henrynester/spinor-r2/hw/r2.1/hn_lib/3dmodels/hn_LED.step

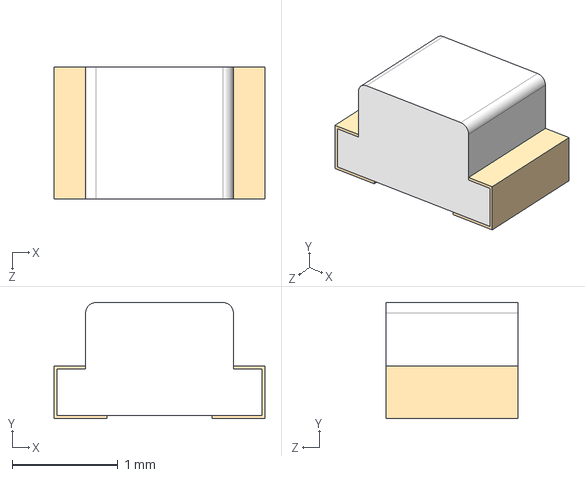
[picture p1: CAD file, 2026-01-27]
hw/r2.1/hn_lib/3dmodels/hn_LED.step
2.00 x 1.10 x 1.25 mm
