henrynester/spinor-r2/hw/r2.1/hn_lib/3dmodels/hn_R_0805.step

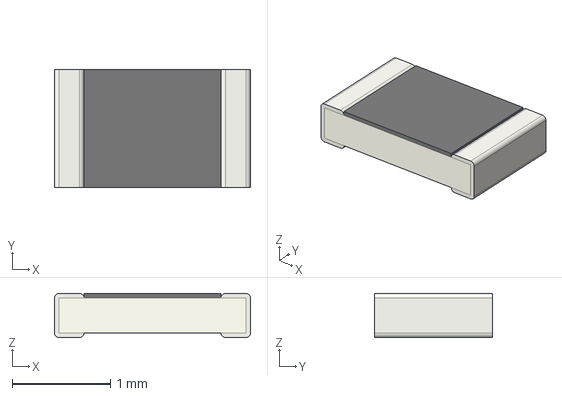
[picture p2: CAD file, 2026-01-27]
hw/r2.1/hn_lib/3dmodels/hn_R_0805.step
2.00 x 1.20 x 0.45 mm
