henrynester/spinor-r2/hw/r2.1/hn_lib/3dmodels/hn_C_0402.step

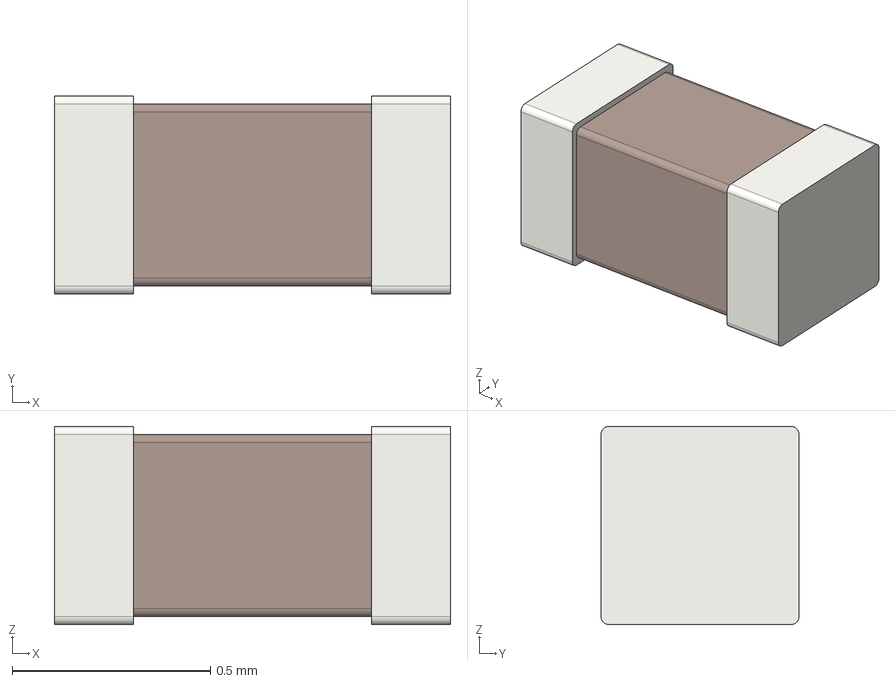
[picture p3: CAD file, 2026-01-27]
hw/r2.1/hn_lib/3dmodels/hn_C_0402.step
1.00 x 0.5 x 0.5 mm
