henrynester/spinor-r2/hw/r2.1/hn_lib/3dmodels/hn_D_SOD-523.step

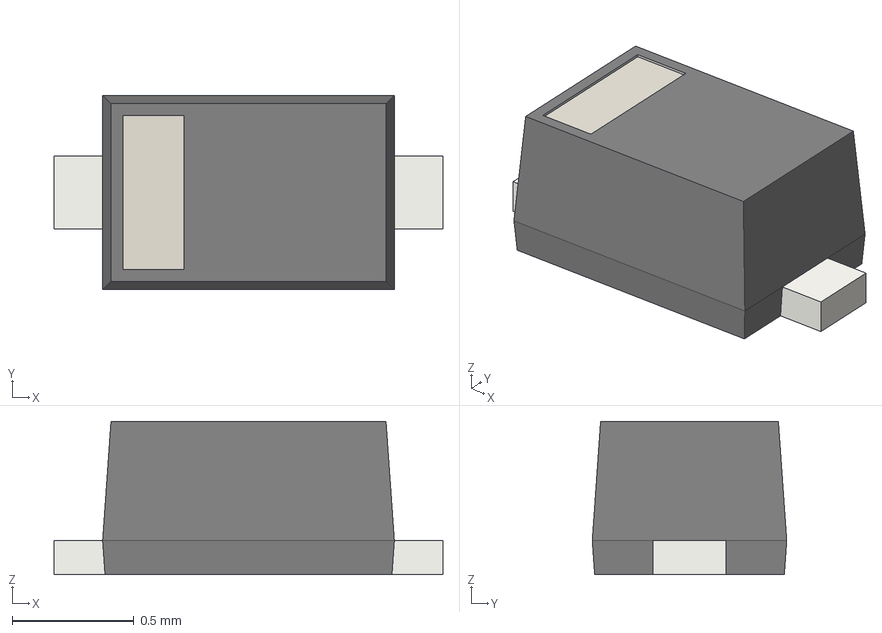
[picture p4: CAD file, 2026-01-27]
hw/r2.1/hn_lib/3dmodels/hn_D_SOD-523.step
1.60 x 0.8 x 0.63 mm
