henrynester/spinor-r2/hw/r2.1/hn_lib/3dmodels/hn_L_Bourns_SRN4026.step

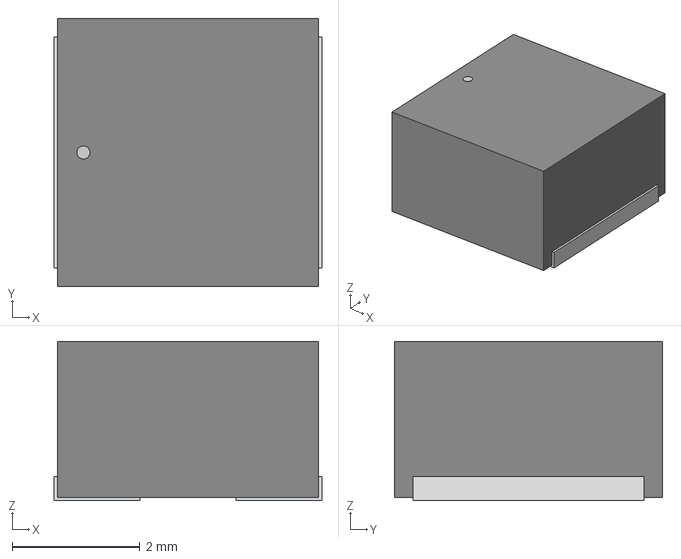
[picture p5: CAD file, 2026-01-27]
hw/r2.1/hn_lib/3dmodels/hn_L_Bourns_SRN4026.step
4.19 x 4.19 x 2.49 mm
