henrynester/spinor-r2/hw/r2.1/hn_lib/3dmodels/hn_QFN40_6x6mm.step

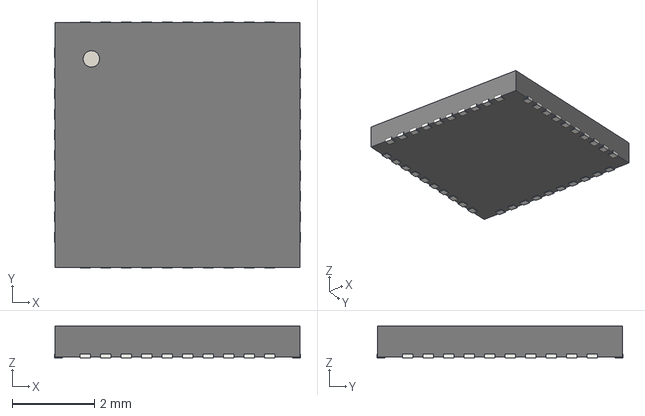
[picture p6: CAD file, 2026-01-27]
hw/r2.1/hn_lib/3dmodels/hn_QFN40_6x6mm.step
6.00 x 6.00 x 0.78 mm
