henrynester/spinor-r2/hw/r2.1/hn_lib/3dmodels/hn_TPS560430X3F.step

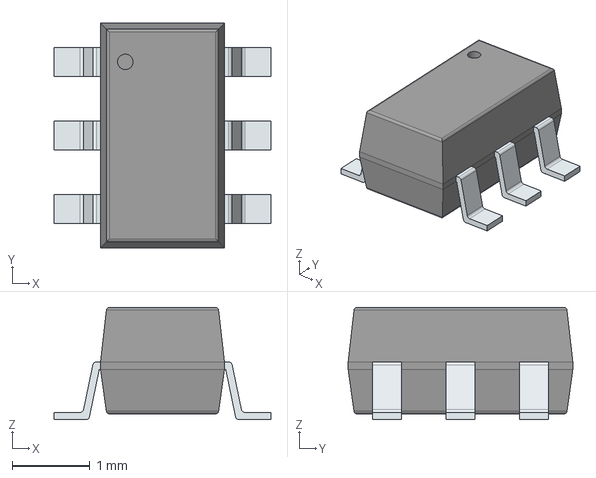
[picture p7: CAD file, 2026-01-27]
hw/r2.1/hn_lib/3dmodels/hn_TPS560430X3F.step
2.80 x 2.90 x 1.45 mm
PinsArrayLR
