henrynester/spinor-r2/hw/r2.1/hn_lib/3dmodels/hn_xtal.step

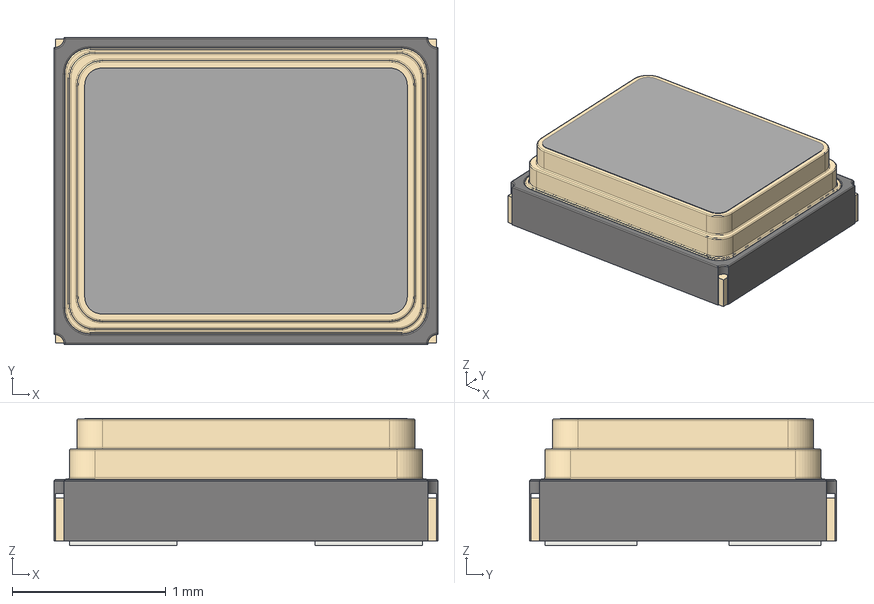
[picture p8: CAD file, 2026-01-27]
hw/r2.1/hn_lib/3dmodels/hn_xtal.step
2.50 x 2.00 x 0.83 mm
