henrynester/spinor-r2/hw/r2.1/hn_lib/3dmodels/hn_SOPAdvance8.step

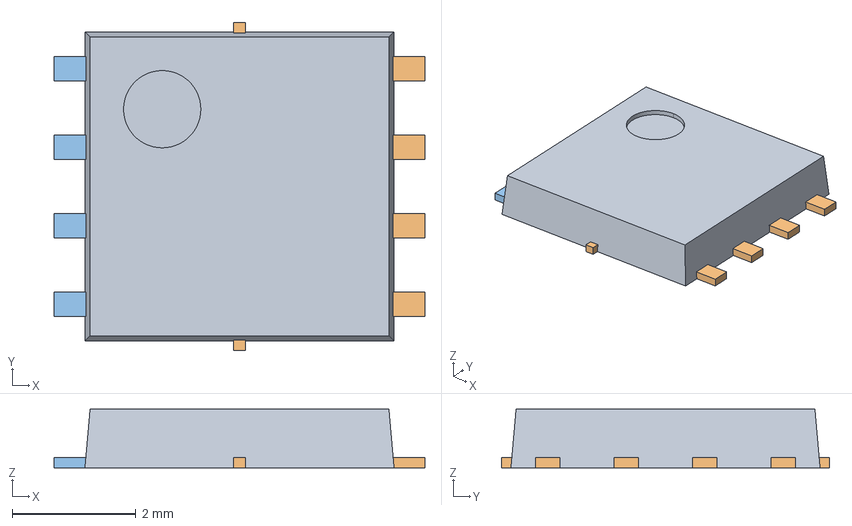
[picture p9: CAD file, 2026-01-27]
hw/r2.1/hn_lib/3dmodels/hn_SOPAdvance8.step
6.00 x 5.30 x 0.95 mm
