henrynester/spinor-r2/hw/r2.1/hn_lib/3dmodels/hn_TSSOP14.step

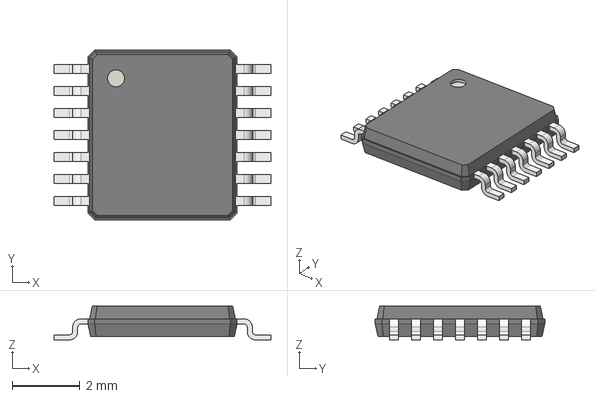
[picture p11: CAD file, 2026-01-27]
hw/r2.1/hn_lib/3dmodels/hn_TSSOP14.step
6.40 x 5.00 x 1 mm
