henrynester/spinor-r2/hw/r2.1/hn_lib/3dmodels/hn_C_Kemet_A768MS.step

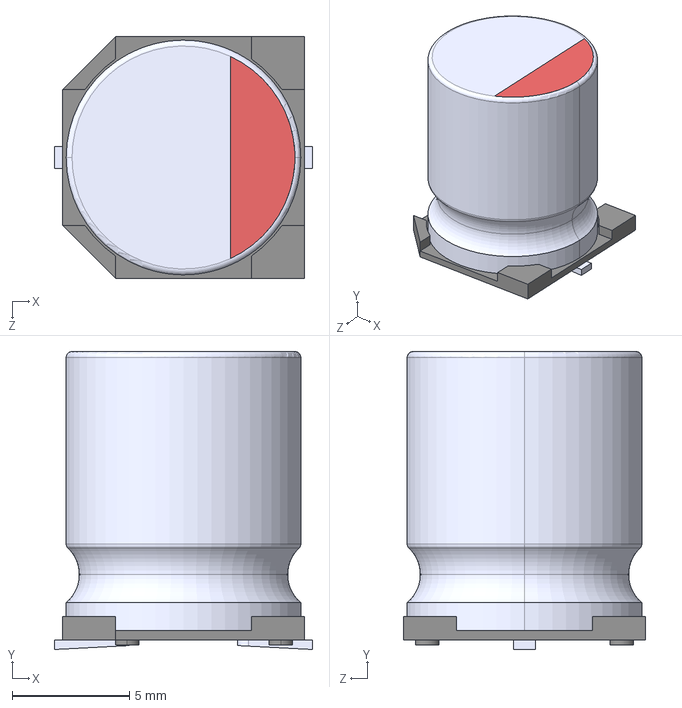
[picture p12: CAD file, 2026-01-27]
hw/r2.1/hn_lib/3dmodels/hn_C_Kemet_A768MS.step
11.0 x 12.7 x 10.3 mm
