henrynester/spinor-r2/hw/r2.1/hn_lib/3dmodels/hn_S3B-XH-SM4-TB.step

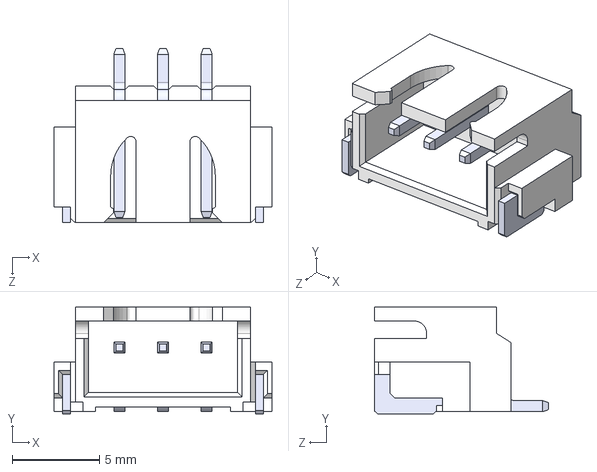
[picture p13: CAD file, 2026-01-27]
hw/r2.1/hn_lib/3dmodels/hn_S3B-XH-SM4-TB.step
12.5 x 6.12 x 10.0 mm
SxB-XH-SM4-TB_3
pin^SxB-XH-SM4-TB Ass x 3
