henrynester/spinor-r2/hw/r2.1/hn_lib/3dmodels/hn_SOT-23-3.step

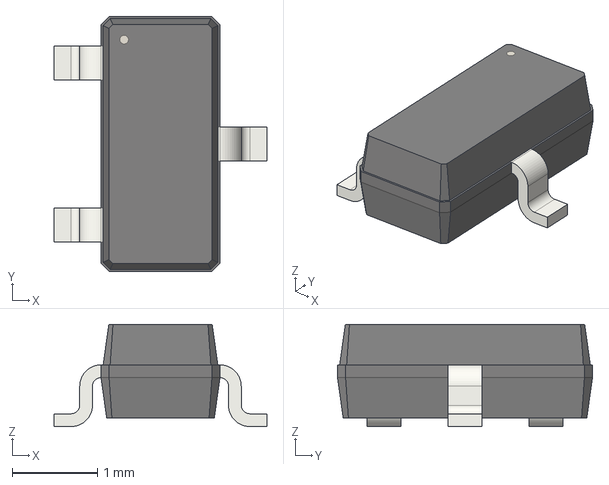
[picture p14: CAD file, 2026-01-27]
hw/r2.1/hn_lib/3dmodels/hn_SOT-23-3.step
2.50 x 3.00 x 1.20 mm
