henrynester/spinor-r2/hw/r2.1/hn_lib/3dmodels/hn_SOIC8.step

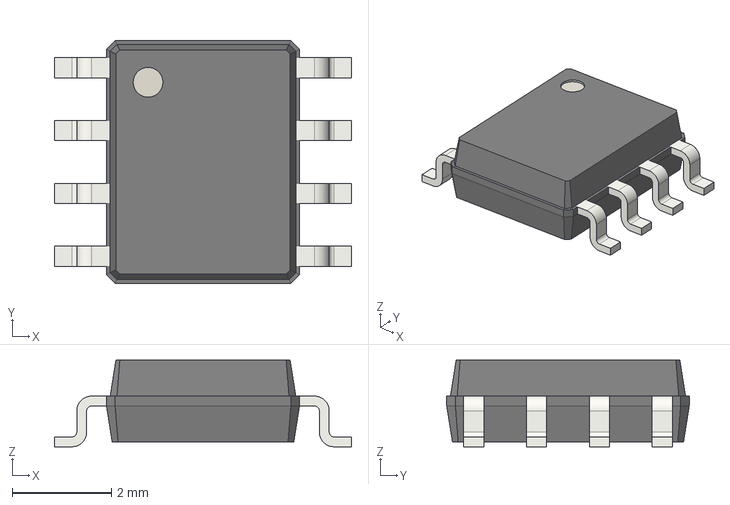
[picture p15: CAD file, 2026-01-27]
hw/r2.1/hn_lib/3dmodels/hn_SOIC8.step
6.00 x 4.90 x 1.75 mm
