henrynester/spinor-r2/hw/r2.1/hn_lib/3dmodels/hn_C_1206.step

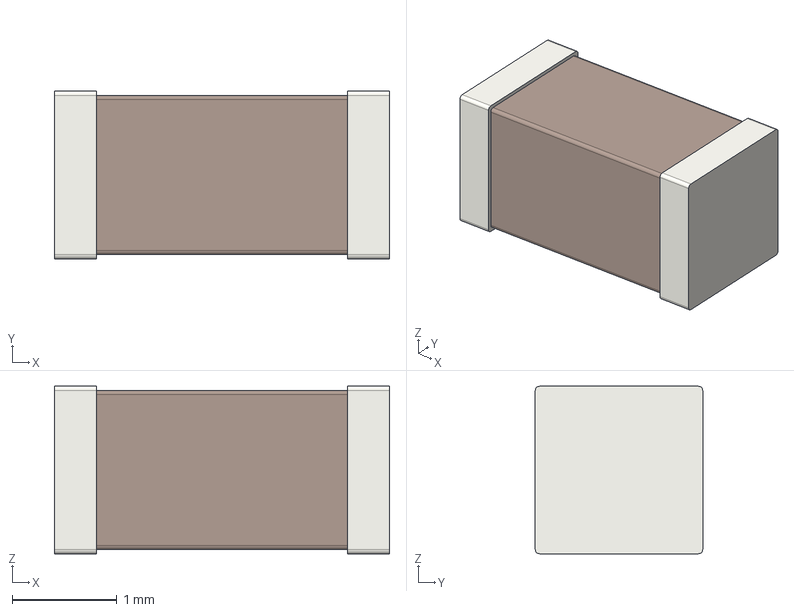
[picture p16: CAD file, 2026-01-27]
hw/r2.1/hn_lib/3dmodels/hn_C_1206.step
3.20 x 1.60 x 1.60 mm
