henrynester/spinor-r2/hw/r2.1/hn_lib/3dmodels/hn_C_0603.step

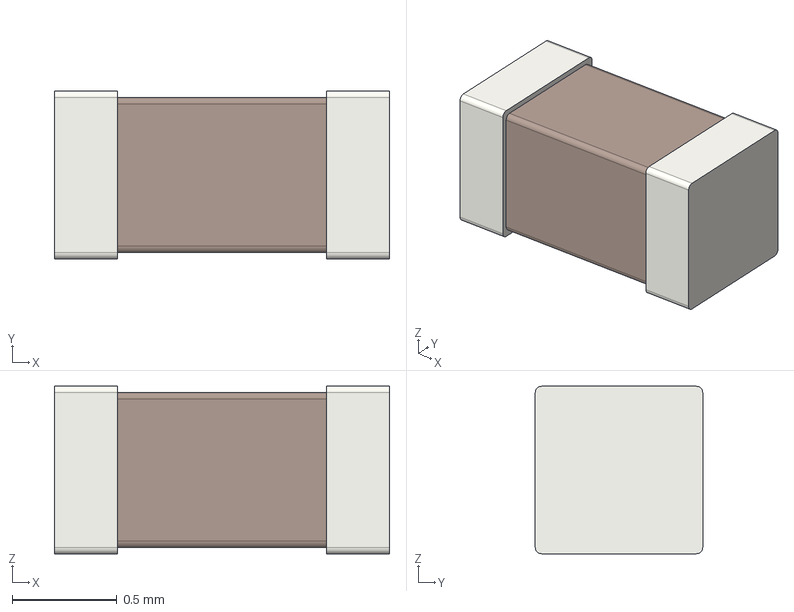
[picture p17: CAD file, 2026-01-27]
hw/r2.1/hn_lib/3dmodels/hn_C_0603.step
1.60 x 0.8 x 0.8 mm
