henrynester/spinor-r2/hw/r2.1/hn_lib/3dmodels/hn_XT30PW-M.step

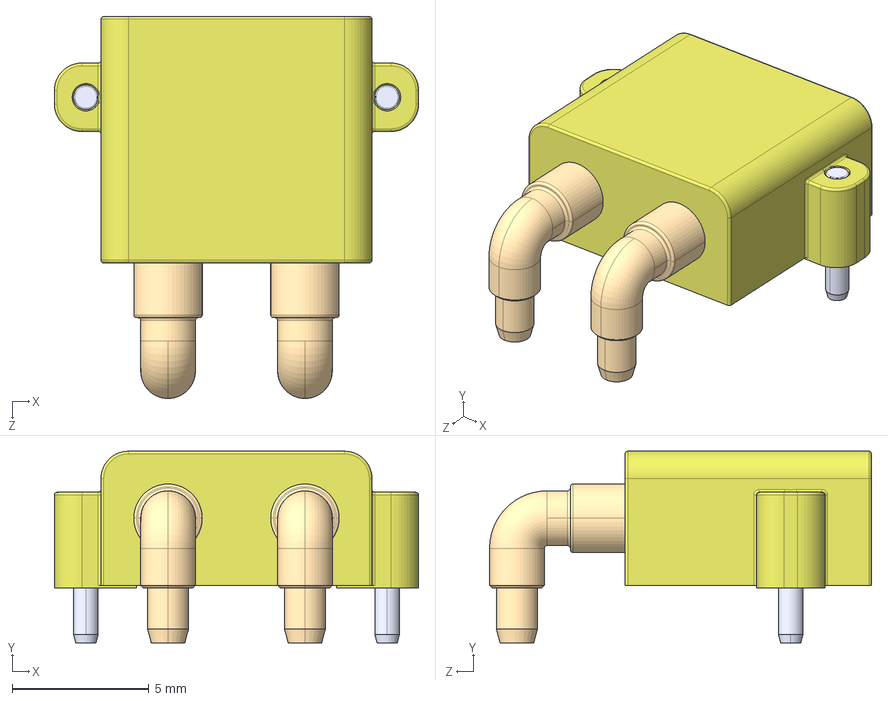
[picture p18: CAD file, 2026-01-27]
hw/r2.1/hn_lib/3dmodels/hn_XT30PW-M.step
13.3 x 7.00 x 14.0 mm
