henrynester/spinor-r2/hw/r2.1/hn_lib/3dmodels/hn_LQFP48.step

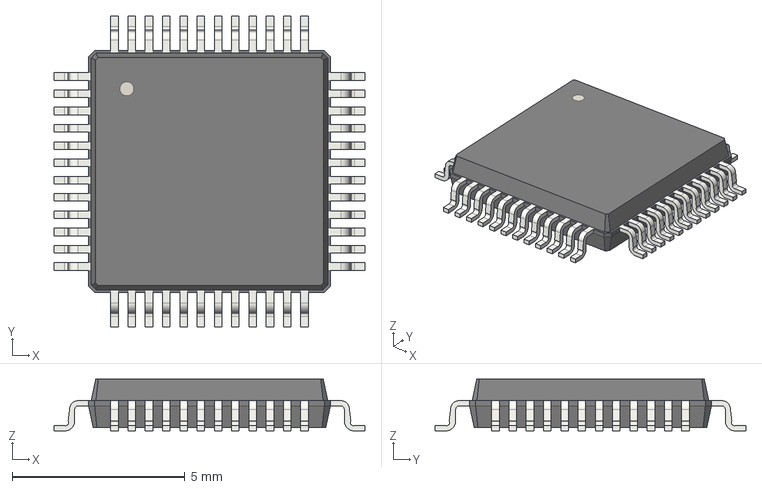
[picture p19: CAD file, 2026-01-27]
hw/r2.1/hn_lib/3dmodels/hn_LQFP48.step
9.00 x 9.00 x 1.50 mm
