henrynester/spinor-r2/hw/r2.1/hn_lib/3dmodels/hn_D_SMB.step

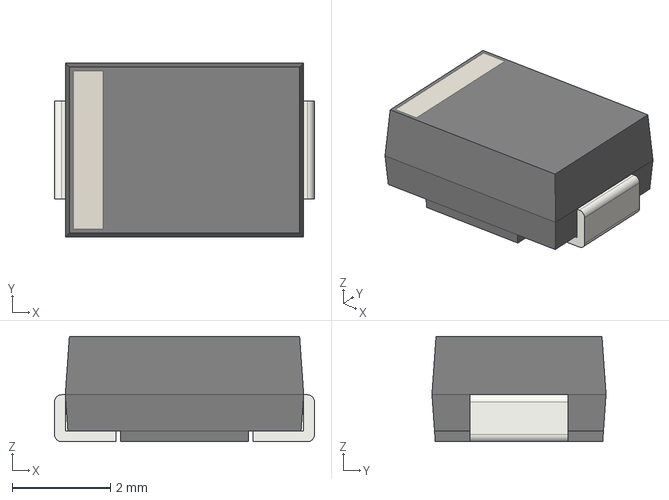
[picture p20: CAD file, 2026-01-27]
hw/r2.1/hn_lib/3dmodels/hn_D_SMB.step
5.30 x 3.55 x 2.15 mm
