henrynester/spinor-r2/hw/r2.1/hn_lib/3dmodels/hn_C_0805.step

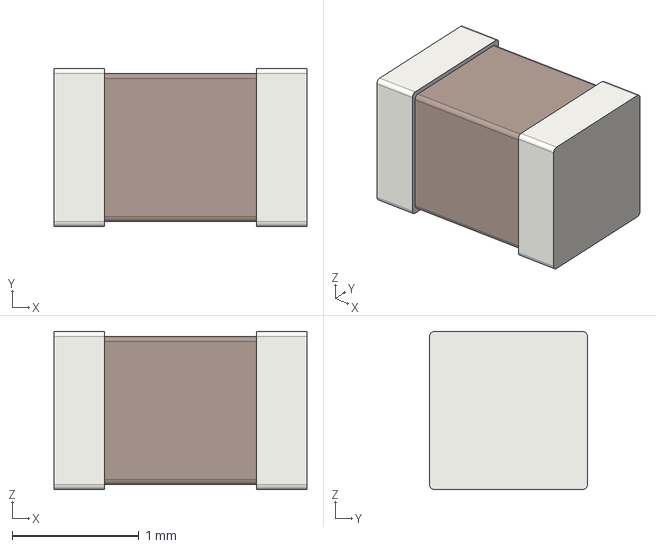
[picture p22: CAD file, 2026-01-27]
hw/r2.1/hn_lib/3dmodels/hn_C_0805.step
2.00 x 1.25 x 1.25 mm
