henrynester/spinor-r2/hw/r2.1/hn_lib/3dmodels/hn_2512_shunt.step

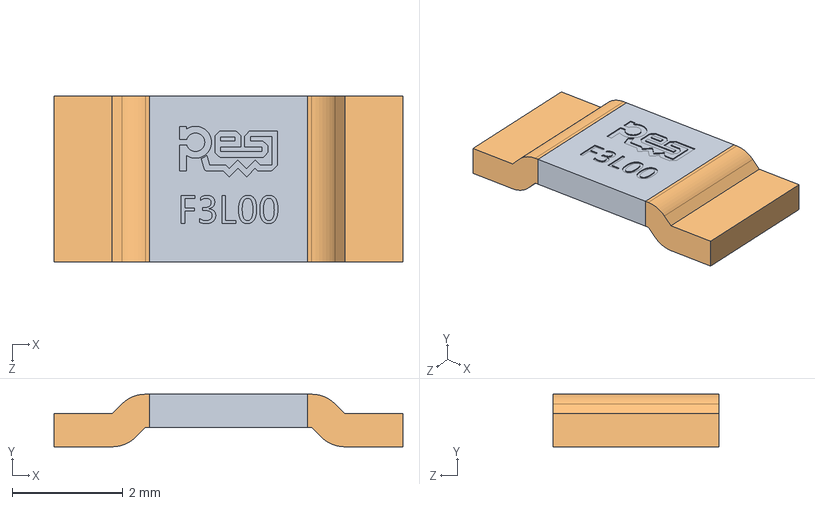
[picture p23: CAD file, 2026-01-27]
hw/r2.1/hn_lib/3dmodels/hn_2512_shunt.step
6.30 x 0.95 x 3.00 mm
