henrynester/spinor-r2/hw/r2.1/spinor-r2a.kicad_pcb

## KiCad design hw/r2.1/spinor-r2a.kicad_pcb (2026-06-20)

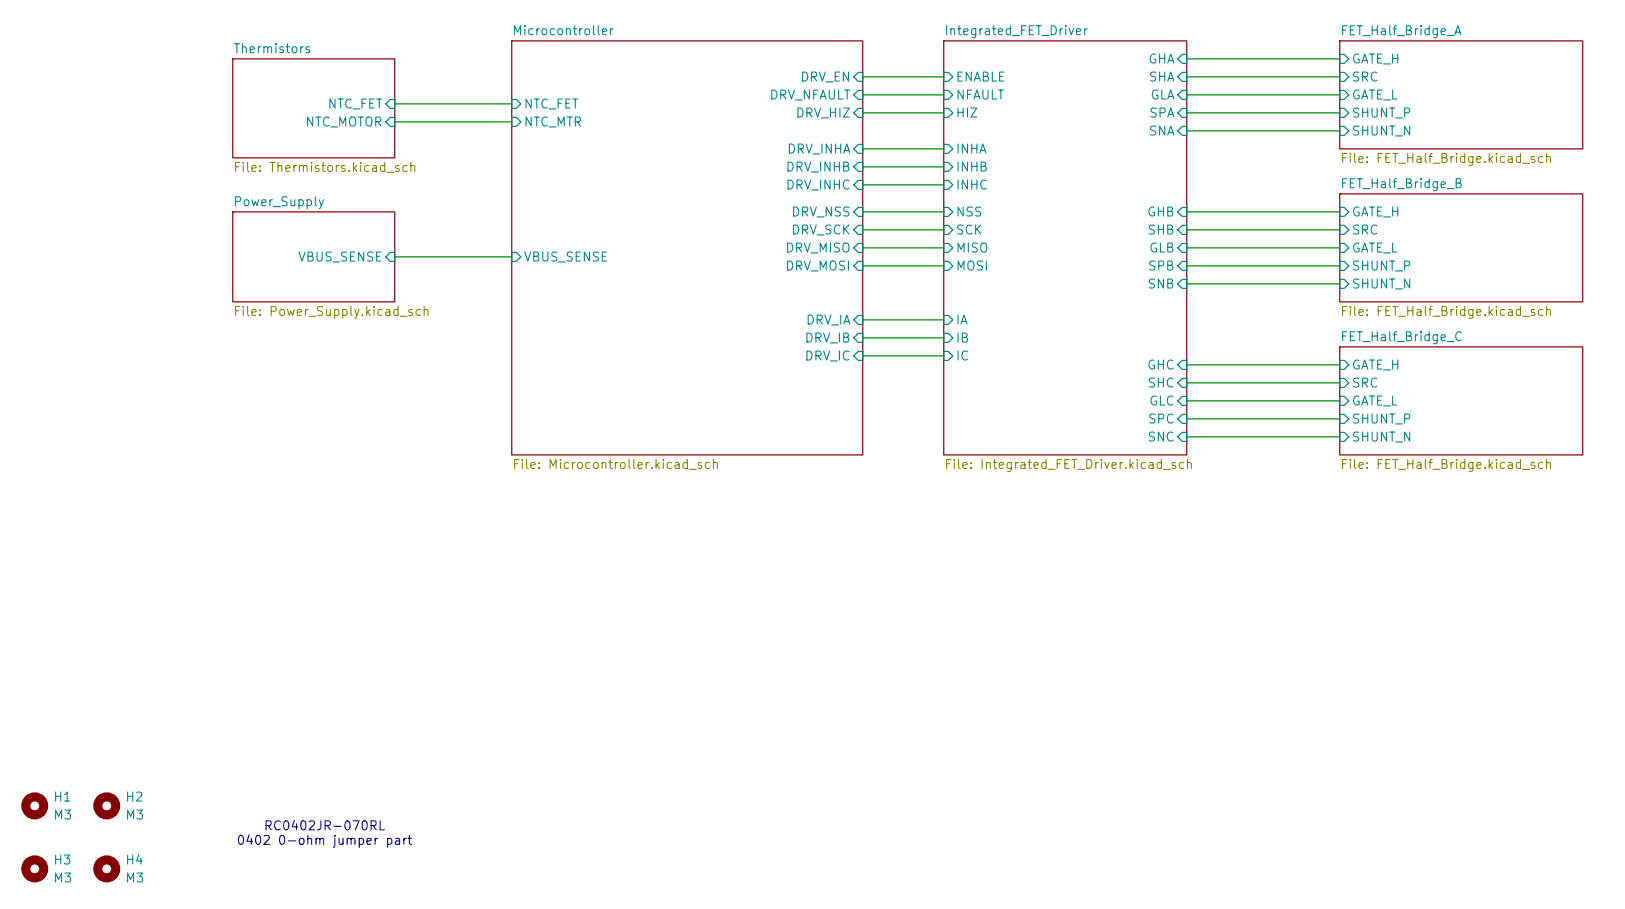
[picture p24: schematic spinor-r2a.kicad_sch]

Parts:
H1, H2, H3, H4: M3; MountingHole_3.2mm_M3_Pad_Via

Notes on the sheet:
RC0402JR-070RL 0402 0-ohm jumper part

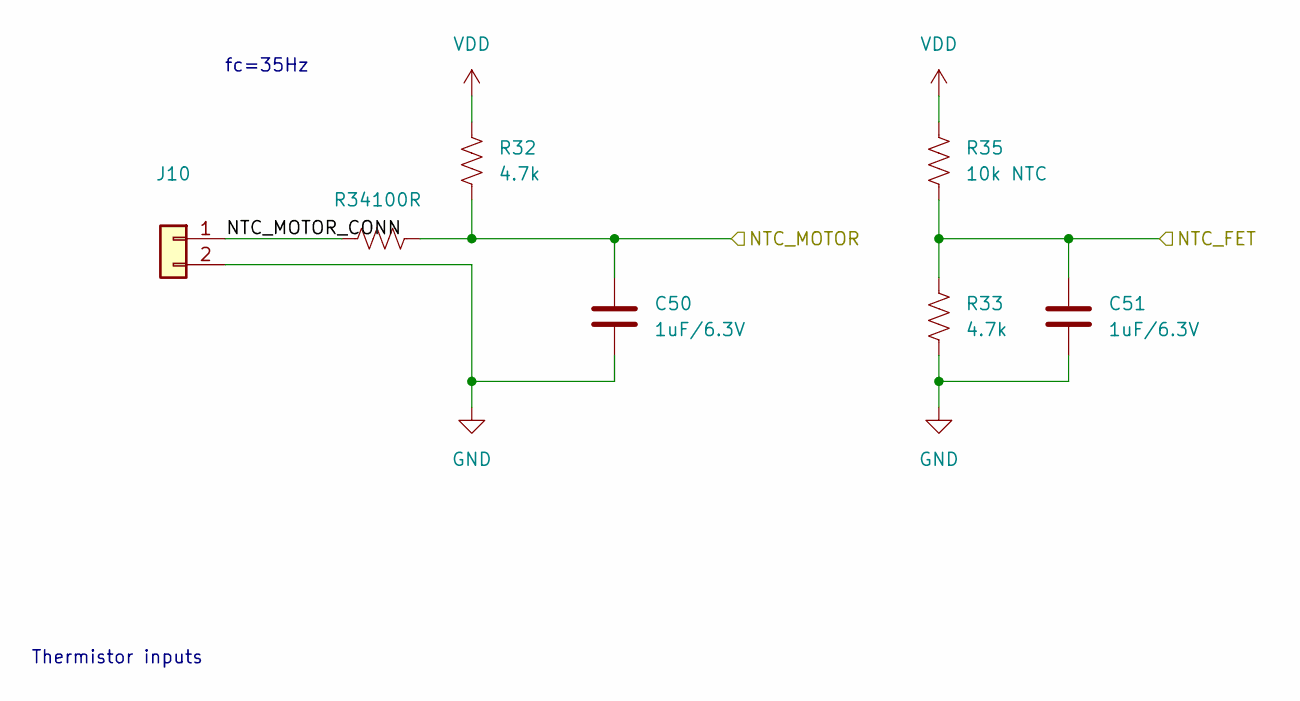
[picture p25: schematic Thermistors.kicad_sch]

Parts:
C50, C51: 1uF/6.3V; hn_C_0402; part Murata GRM155R70J105KA12D
J10: PinHeader_1x02_P1.27mm_Vertical
R32, R33: 4.7k; hn_R_0402; part YAGEO RC0402JR-074K7L
R34: 100R; hn_R_0402; part YAGEO RC0402FR-07100RL
R35: 10k NTC; hn_R_0805; part Murata NCP21XV103J03RA

Connections:
/Microcontroller/ADC12_IN1: C50.1, R32.2, R34.2; also elsewhere on the board
/Microcontroller/ADC12_IN2: C51.1, R33.1, R35.2; also elsewhere on the board
/Thermistors/NTC_MOTOR_CONN: J10.1, R34.1
GND: C50.2, C51.2, J10.2, R33.2; also elsewhere on the board
VDD: R32.1, R35.1; also elsewhere on the board

Notes on the sheet:
fc=35Hz
Thermistor inputs

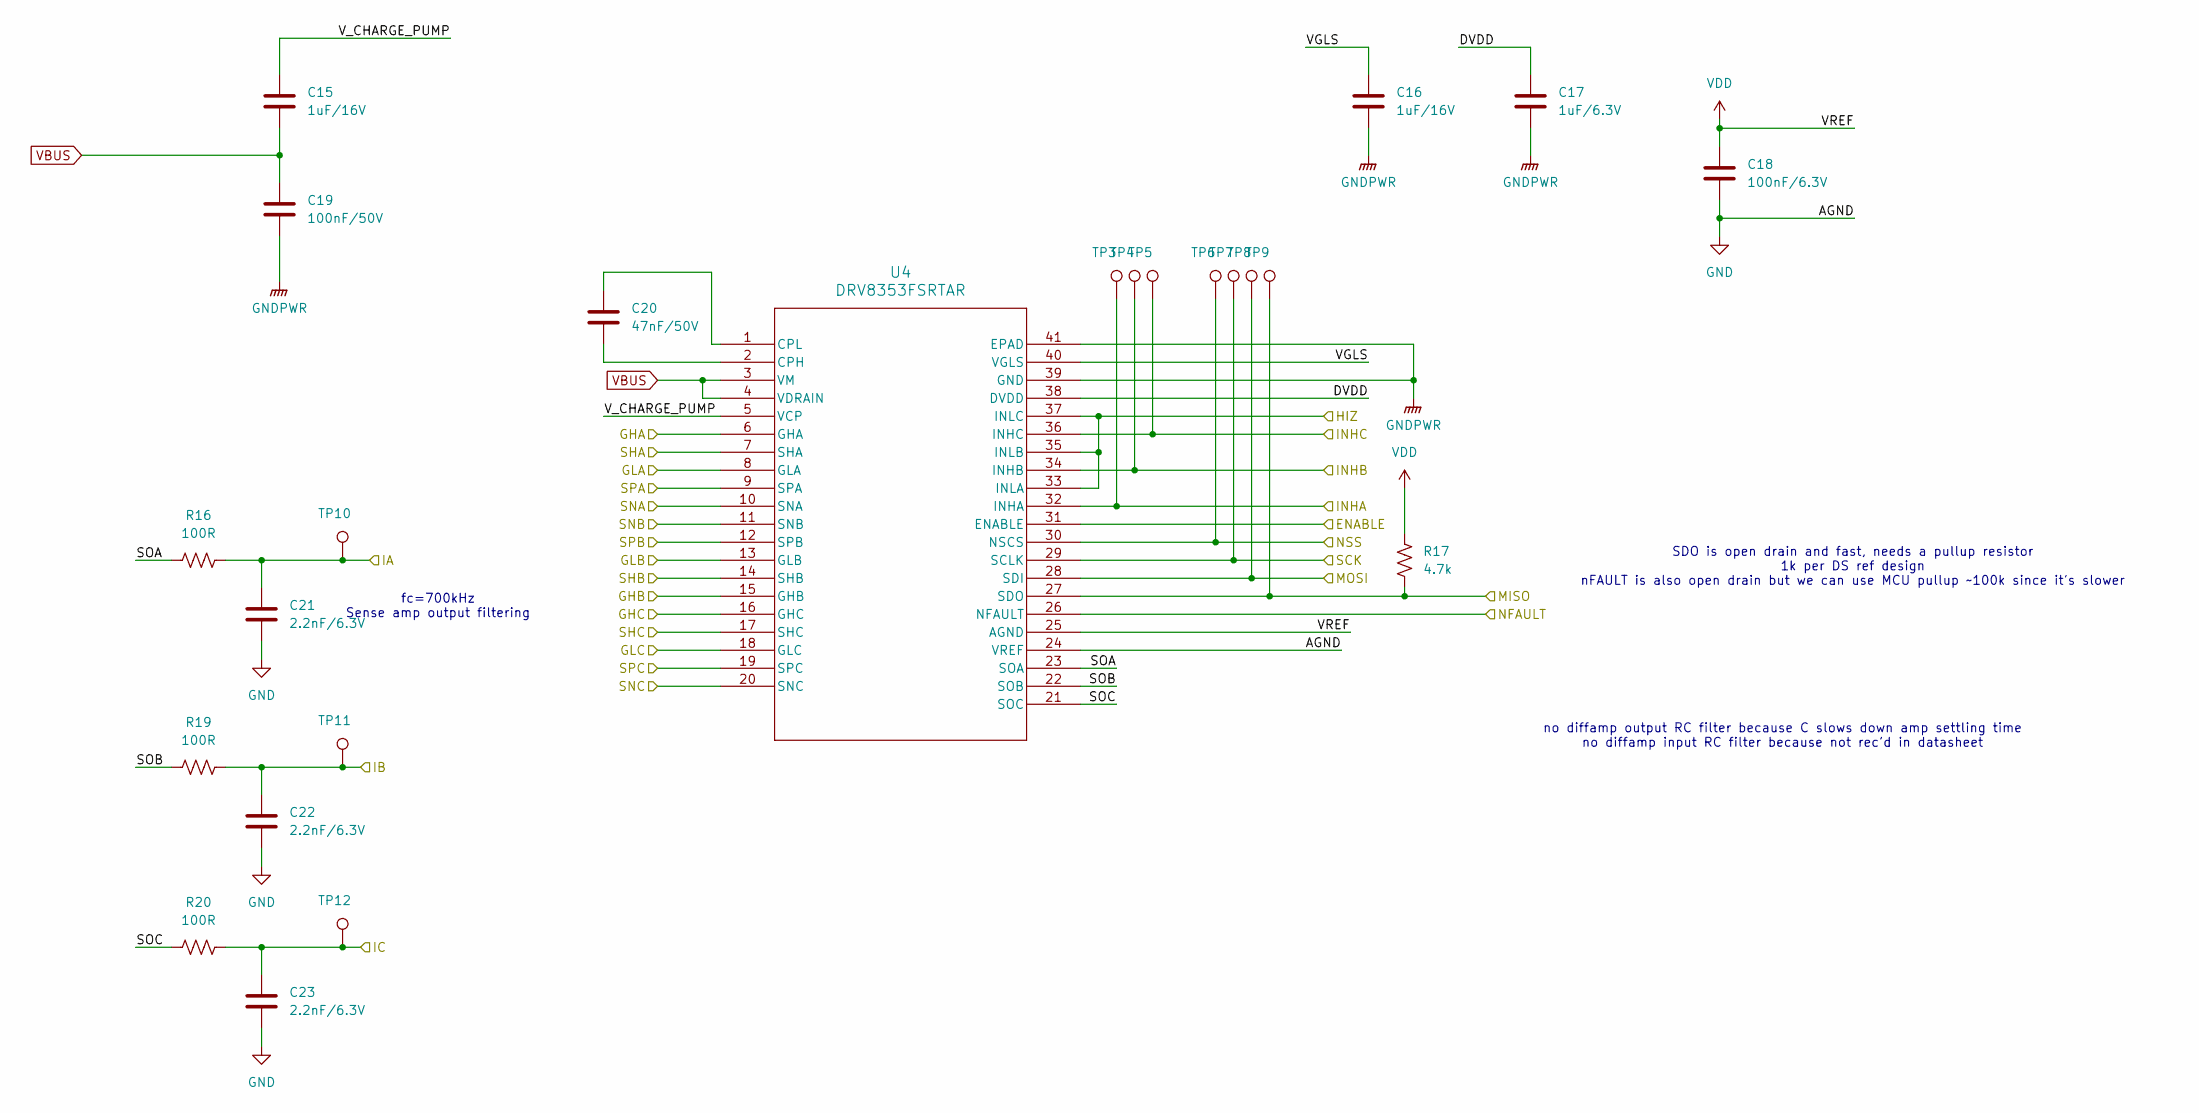
[picture p26: schematic Integrated_FET_Driver.kicad_sch]

Parts:
C15, C16: 1uF/16V; hn_C_0603; part Murata GCM188R71C105KA64D
C17: 1uF/6.3V; hn_C_0402; part Murata GRM155R70J105KA12D
C18: 100nF/6.3V; hn_C_0402; part Murata GRM155R70J104KA01D
C19: 100nF/50V; hn_C_0603; part Murata GCJ188R71H104KA12D
C20: 47nF/50V; hn_C_0402; part Murata GRM155R71H473KE14D
C21, C22, C23: 2.2nF/6.3V; hn_C_0402; part Murata GRM155R70J222KA01D
R16, R19, R20: 100R; hn_R_0402; part YAGEO RC0402FR-07100RL
R17: 4.7k; hn_R_0402; part YAGEO RC0402JR-074K7L
TP3, TP4, TP5, TP6, TP7, TP8, TP9, TP10, TP11, TP12: PinHeader_1x01_P1.00mm_Vertical
U4: DRV8353FSRTAR; hn_TexasInstruments_WQFN40; part Texas Instruments DRV8353FSRTAR

Connections:
/FET_Half_Bridge_A/GATE_H: U4.6 (GHA); also elsewhere on the board
/FET_Half_Bridge_A/GATE_L: U4.8 (GLA); also elsewhere on the board
/FET_Half_Bridge_A/PHASE: U4.7 (SHA); also elsewhere on the board
/FET_Half_Bridge_A/SHUNT_P: U4.9 (SPA); also elsewhere on the board
/FET_Half_Bridge_B/GATE_H: U4.15 (GHB); also elsewhere on the board
/FET_Half_Bridge_B/GATE_L: U4.13 (GLB); also elsewhere on the board
/FET_Half_Bridge_B/PHASE: U4.14 (SHB); also elsewhere on the board
/FET_Half_Bridge_B/SHUNT_P: U4.12 (SPB); also elsewhere on the board
/FET_Half_Bridge_C/GATE_H: U4.16 (GHC); also elsewhere on the board
/FET_Half_Bridge_C/GATE_L: U4.18 (GLC); also elsewhere on the board
/FET_Half_Bridge_C/PHASE: U4.17 (SHC); also elsewhere on the board
/FET_Half_Bridge_C/SHUNT_P: U4.19 (SPC); also elsewhere on the board
/Integrated_FET_Driver/DVDD: C17.1, U4.38 (DVDD)
/Integrated_FET_Driver/SOA: R16.1, U4.23 (SOA)
/Integrated_FET_Driver/SOB: R19.1, U4.22 (SOB)
/Integrated_FET_Driver/SOC: R20.1, U4.21 (SOC)
/Integrated_FET_Driver/VGLS: C16.2, U4.40 (VGLS)
/Integrated_FET_Driver/V_CHARGE_PUMP: C15.2, U4.5 (VCP)
/Microcontroller/ADC1_IN12: C21.1, R16.2, TP10.1; also elsewhere on the board
/Microcontroller/ADC2_IN12: C22.1, R19.2, TP11.1; also elsewhere on the board
/Microcontroller/ADC3_IN12: C23.1, R20.2, TP12.1; also elsewhere on the board
/Microcontroller/PA7: U4.31 (ENABLE); also elsewhere on the board
/Microcontroller/PA11: U4.33 (INLA), U4.35 (INLB), U4.37 (INLC); also elsewhere on the board
/Microcontroller/PA12: U4.26 (NFAULT); also elsewhere on the board
/Microcontroller/SPI1_MISO: R17.2, TP9.1, U4.27 (SDO); also elsewhere on the board
/Microcontroller/SPI1_MOSI: TP8.1, U4.28 (SDI); also elsewhere on the board
/Microcontroller/SPI1_NSS: TP6.1, U4.30 (NSCS); also elsewhere on the board
/Microcontroller/SPI1_SCK: TP7.1, U4.29 (SCLK); also elsewhere on the board
/Microcontroller/TIM1_CH1: TP3.1, U4.32 (INHA); also elsewhere on the board
/Microcontroller/TIM1_CH2: TP4.1, U4.34 (INHB); also elsewhere on the board
/Microcontroller/TIM1_CH3: TP5.1, U4.36 (INHC); also elsewhere on the board
GND: C16.1, C17.2, C18.2, C19.2, C21.2, C22.2, C23.2, U4.10 (SNA), U4.11 (SNB), U4.20 (SNC), U4.24 (VREF), U4.39 (GND), U4.41 (EPAD); also elsewhere on the board
unnamed: C20.2, U4.2 (CPH)
unnamed: C20.1, U4.1 (CPL)
VBUS: C15.1, C19.1, U4.3 (VM), U4.4 (VDRAIN); also elsewhere on the board
VDD: C18.1, R17.1, U4.25 (AGND); also elsewhere on the board

Notes on the sheet:
SDO is open drain and fast, needs a pullup resistor 1k per DS ref design nFAULT is also open drain but we can use MCU pullup ~100k since it's slower
fc=700kHz Sense amp output filtering
no diffamp output RC filter because C slows down amp settling time no diffamp input RC filter because not rec'd in datasheet

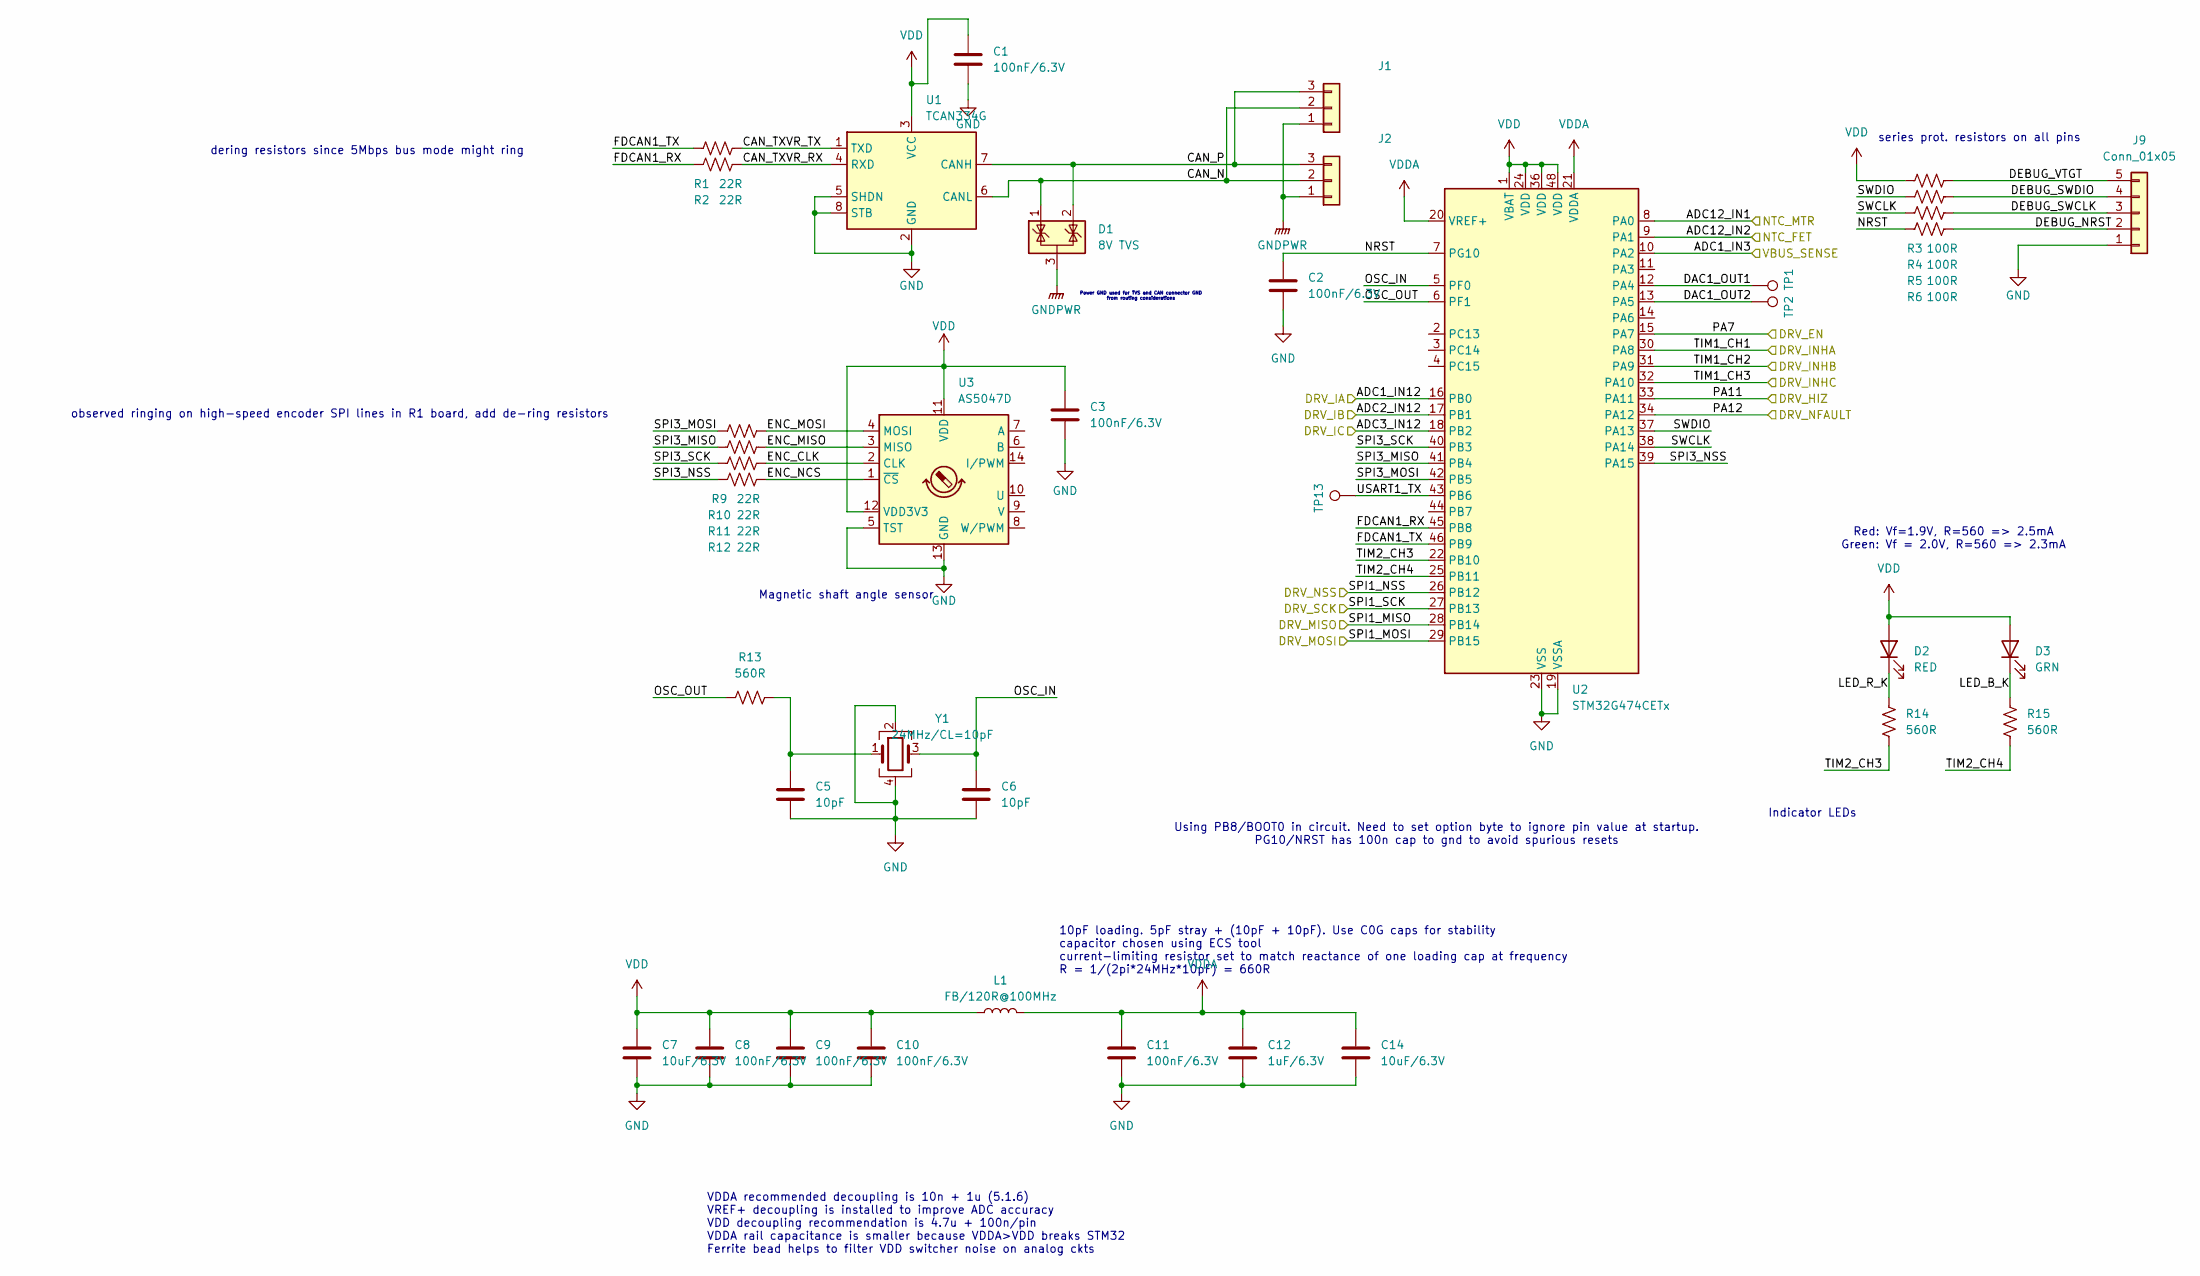
[picture p27: schematic Microcontroller.kicad_sch]

Parts:
C1, C2, C3, C8, C9, C10, C11: 100nF/6.3V; hn_C_0402; part Murata GRM155R70J104KA01D
C5, C6: 10pF; hn_C_0402; part Murata GRM1555C1H100FA01D
C7, C14: 10uF/6.3V; hn_C_0805; part Murata GCM21BR70J106KE22L
C12: 1uF/6.3V; hn_C_0402; part Murata GRM155R70J105KA12D
D1: 8V TVS; hn_SOT-23-3; part Wurth 824022
D2: RED; hn_LED_LiteOn; part LiteOn LTST-C171KRKT
D3: GRN; hn_LED_LiteOn; part LiteOn LTST-C171TGKT
J1, J2: hn_JST_XH_S3B-XH-SM4-TB_1x03-1MP_P2.50mm_Horizontal; part JST S3B-XH-SM4-TB
J9: Conn_01x05; PinHeader_1x05_P2.54mm_Vertical
L1: FB/120R@100MHz; hn_R_0805; part Laird SiLaird HI0805O121R-10
R1, R2, R9, R10, R11, R12: 22R; hn_R_0402; part YAGEO RC0402FR-0722RL
R3, R4, R5, R6: 100R; hn_R_0402; part YAGEO RC0402FR-07100RL
R13, R14, R15: 560R; hn_R_0402; part YAGEO RC0402JR-07560RL
TP1, TP2, TP13: PinHeader_1x01_P1.00mm_Vertical
U1: TCAN334G; hn_SOIC8; part Texas Instruments TCAN334G
U2: STM32G474CETx; hn_LQFP48; part STMicroelectronics STM32G474CET6
U3: AS5047D; hn_TSSOP14; part AMS Osram AS5047D
Y1: 24MHz/CL=10pF; hn_XTAL; part ECS ECS-240-10-36-JGN-TR

Connections:
/Microcontroller/ADC1_IN3: U2.10 (PA2); also elsewhere on the board
/Microcontroller/ADC1_IN12: U2.16 (PB0); also elsewhere on the board
/Microcontroller/ADC2_IN12: U2.17 (PB1); also elsewhere on the board
/Microcontroller/ADC3_IN12: U2.18 (PB2); also elsewhere on the board
/Microcontroller/ADC12_IN1: U2.8 (PA0); also elsewhere on the board
/Microcontroller/ADC12_IN2: U2.9 (PA1); also elsewhere on the board
/Microcontroller/CAN_N: D1.1 (K), J1.2, J2.2, U1.6 (CANL)
/Microcontroller/CAN_P: D1.2 (K), J1.3, J2.3, U1.7 (CANH)
/Microcontroller/CAN_TXVR_RX: R2.1, U1.4 (RXD)
/Microcontroller/CAN_TXVR_TX: R1.1, U1.1 (TXD)
/Microcontroller/DAC1_OUT1: TP1.1, U2.12 (PA4)
/Microcontroller/DAC1_OUT2: TP2.1, U2.13 (PA5)
/Microcontroller/DEBUG_NRST: J9.2, R6.2
/Microcontroller/DEBUG_SWCLK: J9.3, R5.2
/Microcontroller/DEBUG_SWDIO: J9.4, R4.2
/Microcontroller/DEBUG_VTGT: J9.5, R3.2
/Microcontroller/ENC_CLK: R11.1, U3.2 (CLK)
/Microcontroller/ENC_MISO: R10.1, U3.3 (MISO)
/Microcontroller/ENC_MOSI: R9.1, U3.4 (MOSI)
/Microcontroller/ENC_NCS: R12.1, U3.1 (~CS)
/Microcontroller/FDCAN1_RX: R2.2, U2.45 (PB8)
/Microcontroller/FDCAN1_TX: R1.2, U2.46 (PB9)
/Microcontroller/LED_B_K: D3.1 (K), R15.2
/Microcontroller/LED_R_K: D2.1 (K), R14.2
/Microcontroller/NRST: C2.1, R6.1, U2.7 (PG10)
/Microcontroller/OSC_IN: C6.1, U2.5 (PF0), Y1.3
/Microcontroller/OSC_OUT: R13.2, U2.6 (PF1)
/Microcontroller/PA7: U2.15 (PA7); also elsewhere on the board
/Microcontroller/PA11: U2.33 (PA11); also elsewhere on the board
/Microcontroller/PA12: U2.34 (PA12); also elsewhere on the board
/Microcontroller/SPI1_MISO: U2.28 (PB14); also elsewhere on the board
/Microcontroller/SPI1_MOSI: U2.29 (PB15); also elsewhere on the board
/Microcontroller/SPI1_NSS: U2.26 (PB12); also elsewhere on the board
/Microcontroller/SPI1_SCK: U2.27 (PB13); also elsewhere on the board
/Microcontroller/SPI3_MISO: R10.2, U2.41 (PB4)
/Microcontroller/SPI3_MOSI: R9.2, U2.42 (PB5)
/Microcontroller/SPI3_NSS: R12.2, U2.39 (PA15)
/Microcontroller/SPI3_SCK: R11.2, U2.40 (PB3)
/Microcontroller/SWCLK: R5.1, U2.38 (PA14)
/Microcontroller/SWDIO: R4.1, U2.37 (PA13)
/Microcontroller/TIM1_CH1: U2.30 (PA8); also elsewhere on the board
/Microcontroller/TIM1_CH2: U2.31 (PA9); also elsewhere on the board
/Microcontroller/TIM1_CH3: U2.32 (PA10); also elsewhere on the board
/Microcontroller/TIM2_CH3: R14.1, U2.22 (PB10)
/Microcontroller/TIM2_CH4: R15.1, U2.25 (PB11)
/Microcontroller/USART1_TX: TP13.1, U2.43 (PB6)
GND: C1.2, C2.2, C3.2, C5.2, C6.2, C7.2, C8.2, C9.2, C10.2, C11.2, C12.2, C14.2, D1.3 (A), J1.1, J2.1, J9.1, U1.2 (GND), U1.5 (SHDN), U1.8 (STB), U2.19 (VSSA), U2.23 (VSS), U2.35 (VSS), U2.47 (VSS), U3.5 (TST), U3.13 (GND), Y1.2, Y1.4; also elsewhere on the board
unnamed: C5.1, R13.1, Y1.1
VDD: C1.1, C3.1, C7.1, C8.1, C9.1, C10.1, D2.2 (A), D3.2 (A), L1.1, R3.1, U1.3 (VCC), U2.1 (VBAT), U2.24 (VDD), U2.36 (VDD), U2.48 (VDD), U3.11 (VDD), U3.12 (VDD3V3); also elsewhere on the board
VDDA: C11.1, C12.1, C14.1, L1.2, U2.20 (VREF+), U2.21 (VDDA)

Notes on the sheet:
10pF loading. 5pF stray + (10pF + 10pF). Use C0G caps for stability capacitor chosen using ECS tool current-limiting resistor set to match reactance of one loading cap at frequency R = 1/(2pi*24MHz*10pF) = 660R
VDDA recommended decoupling is 10n + 1u (5.1.6) VREF+ decoupling is installed to improve ADC accuracy VDD decoupling recommendation is 4.7u + 100n/pin VDDA rail capacitance is smaller because VDDA>VDD breaks STM32 Ferrite bead helps to filter VDD switcher noise on analog ckts
Indicator LEDs
Using PB8/BOOT0 in circuit. Need to set option byte to ignore pin value at startup. PG10/NRST has 100n cap to gnd to avoid spurious resets
observed ringing on high-speed encoder SPI lines in R1 board, add de-ring resistors
series prot. resistors on all pins
Magnetic shaft angle sensor
dering resistors since 5Mbps bus mode might ring
Red: Vf=1.9V, R=560 => 2.5mA Green: Vf = 2.0V, R=560 => 2.3mA
Power GND used for TVS and CAN connector GND from routing considerations

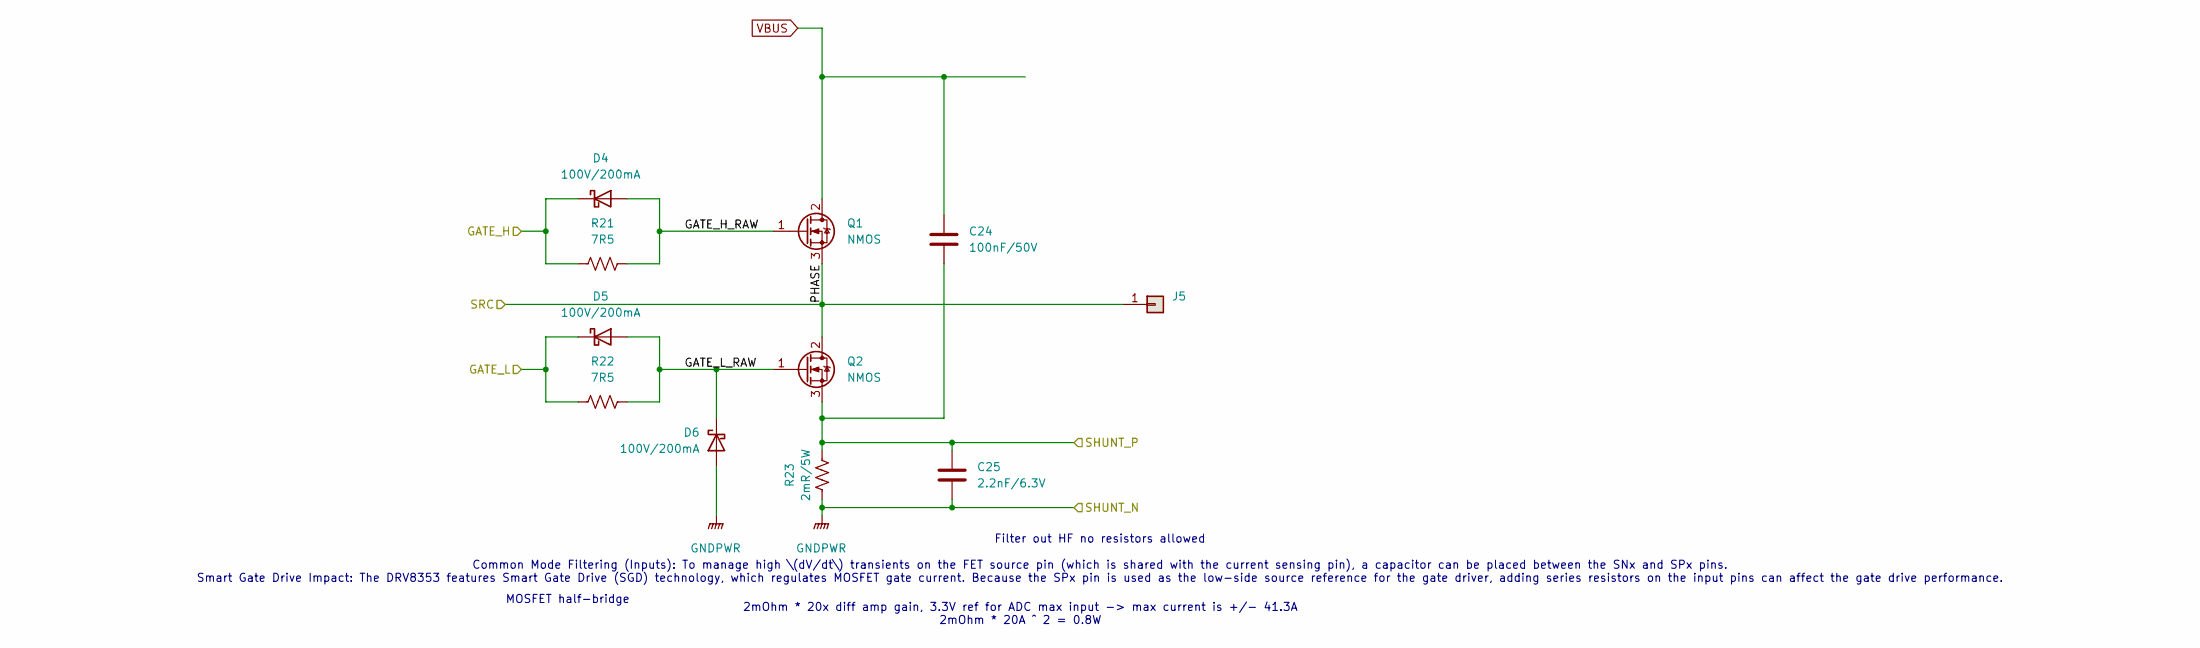
[picture p28: schematic FET_Half_Bridge.kicad_sch]

Parts:
C24: 100nF/50V; hn_C_0603; part Murata GCJ188R71H104KA12D
C25: 2.2nF/6.3V; hn_C_0402; part Murata GRM155R70J222KA01D
D4, D5, D6: 100V/200mA; hn_D_SOD-523; part STMicroelectronics BAT41KFILM
J5: SolderWire-1.5sqmm_1x01_D1.7mm_OD3.9mm
Q1, Q2: NMOS; hn_FET_Toshiba_SOPADVANCE8; part Toshiba TPH2R506PL,L1Q
R21, R22: 7R5; hn_R_0402; part YAGEO RC0402FR-077R5L
R23: 2mR/5W; hn_R_2512_shunt; part PEWF2512F2L00Q9

Connections:
/FET_Half_Bridge_A/GATE_H: D4.1 (K), R21.1; also elsewhere on the board
/FET_Half_Bridge_A/GATE_H_RAW: D4.2 (A), Q1.1 (G), R21.2
/FET_Half_Bridge_A/GATE_L: D5.1 (K), R22.1; also elsewhere on the board
/FET_Half_Bridge_A/GATE_L_RAW: D5.2 (A), D6.1 (K), Q2.1 (G), R22.2
/FET_Half_Bridge_A/PHASE: J5.1, Q1.3 (S), Q2.2 (D); also elsewhere on the board
/FET_Half_Bridge_A/SHUNT_P: C24.2, C25.1, Q2.3 (S), R23.1; also elsewhere on the board
GND: C25.2, D6.2 (A), R23.2; also elsewhere on the board
VBUS: C24.1, Q1.2 (D); also elsewhere on the board

Parts of its further copies:
C26, C28: 100nF/50V; hn_C_0603; part Murata GCJ188R71H104KA12D
C27, C29: 2.2nF/6.3V; hn_C_0402; part Murata GRM155R70J222KA01D
D7, D8, D9, D10, D11, D12: 100V/200mA; hn_D_SOD-523; part STMicroelectronics BAT41KFILM
J6, J7: SolderWire-1.5sqmm_1x01_D1.7mm_OD3.9mm
Q3, Q4, Q5, Q6: NMOS; hn_FET_Toshiba_SOPADVANCE8; part Toshiba TPH2R506PL,L1Q
R24, R25, R27, R28: 7R5; hn_R_0402; part YAGEO RC0402FR-077R5L
R26, R29: 2mR/5W; hn_R_2512_shunt; part PEWF2512F2L00Q9

Connections of its further copies:
/FET_Half_Bridge_B/GATE_H: D7.1 (K), R24.1; also elsewhere on the board
/FET_Half_Bridge_B/GATE_H_RAW: D7.2 (A), Q3.1 (G), R24.2
/FET_Half_Bridge_B/GATE_L: D8.1 (K), R25.1; also elsewhere on the board
/FET_Half_Bridge_B/GATE_L_RAW: D8.2 (A), D9.1 (K), Q4.1 (G), R25.2
/FET_Half_Bridge_B/PHASE: J6.1, Q3.3 (S), Q4.2 (D); also elsewhere on the board
/FET_Half_Bridge_B/SHUNT_P: C26.2, C27.1, Q4.3 (S), R26.1; also elsewhere on the board
/FET_Half_Bridge_C/GATE_H: D10.1 (K), R27.1; also elsewhere on the board
/FET_Half_Bridge_C/GATE_H_RAW: D10.2 (A), Q5.1 (G), R27.2
/FET_Half_Bridge_C/GATE_L: D11.1 (K), R28.1; also elsewhere on the board
/FET_Half_Bridge_C/GATE_L_RAW: D11.2 (A), D12.1 (K), Q6.1 (G), R28.2
/FET_Half_Bridge_C/PHASE: J7.1, Q5.3 (S), Q6.2 (D); also elsewhere on the board
/FET_Half_Bridge_C/SHUNT_P: C28.2, C29.1, Q6.3 (S), R29.1; also elsewhere on the board
GND: C27.2, C29.2, D9.2 (A), D12.2 (A), R26.2, R29.2; also elsewhere on the board
VBUS: C26.1, C28.1, Q3.2 (D), Q5.2 (D); also elsewhere on the board

Notes on the sheet:
2mOhm * 20x diff amp gain, 3.3V ref for ADC max input -> max current is +/- 41.3A 2mOhm * 20A ^ 2 = 0.8W
MOSFET half-bridge
Filter out HF no resistors allowed Common Mode Filtering (Inputs): To manage high \(dV/dt\) transients on the FET source pin (which is shared with the current sensing pin), a capacitor can be placed between the SNx and SPx pins. Smart Gate Drive Impact: The DRV8353 features Smart Gate Drive (SGD) t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

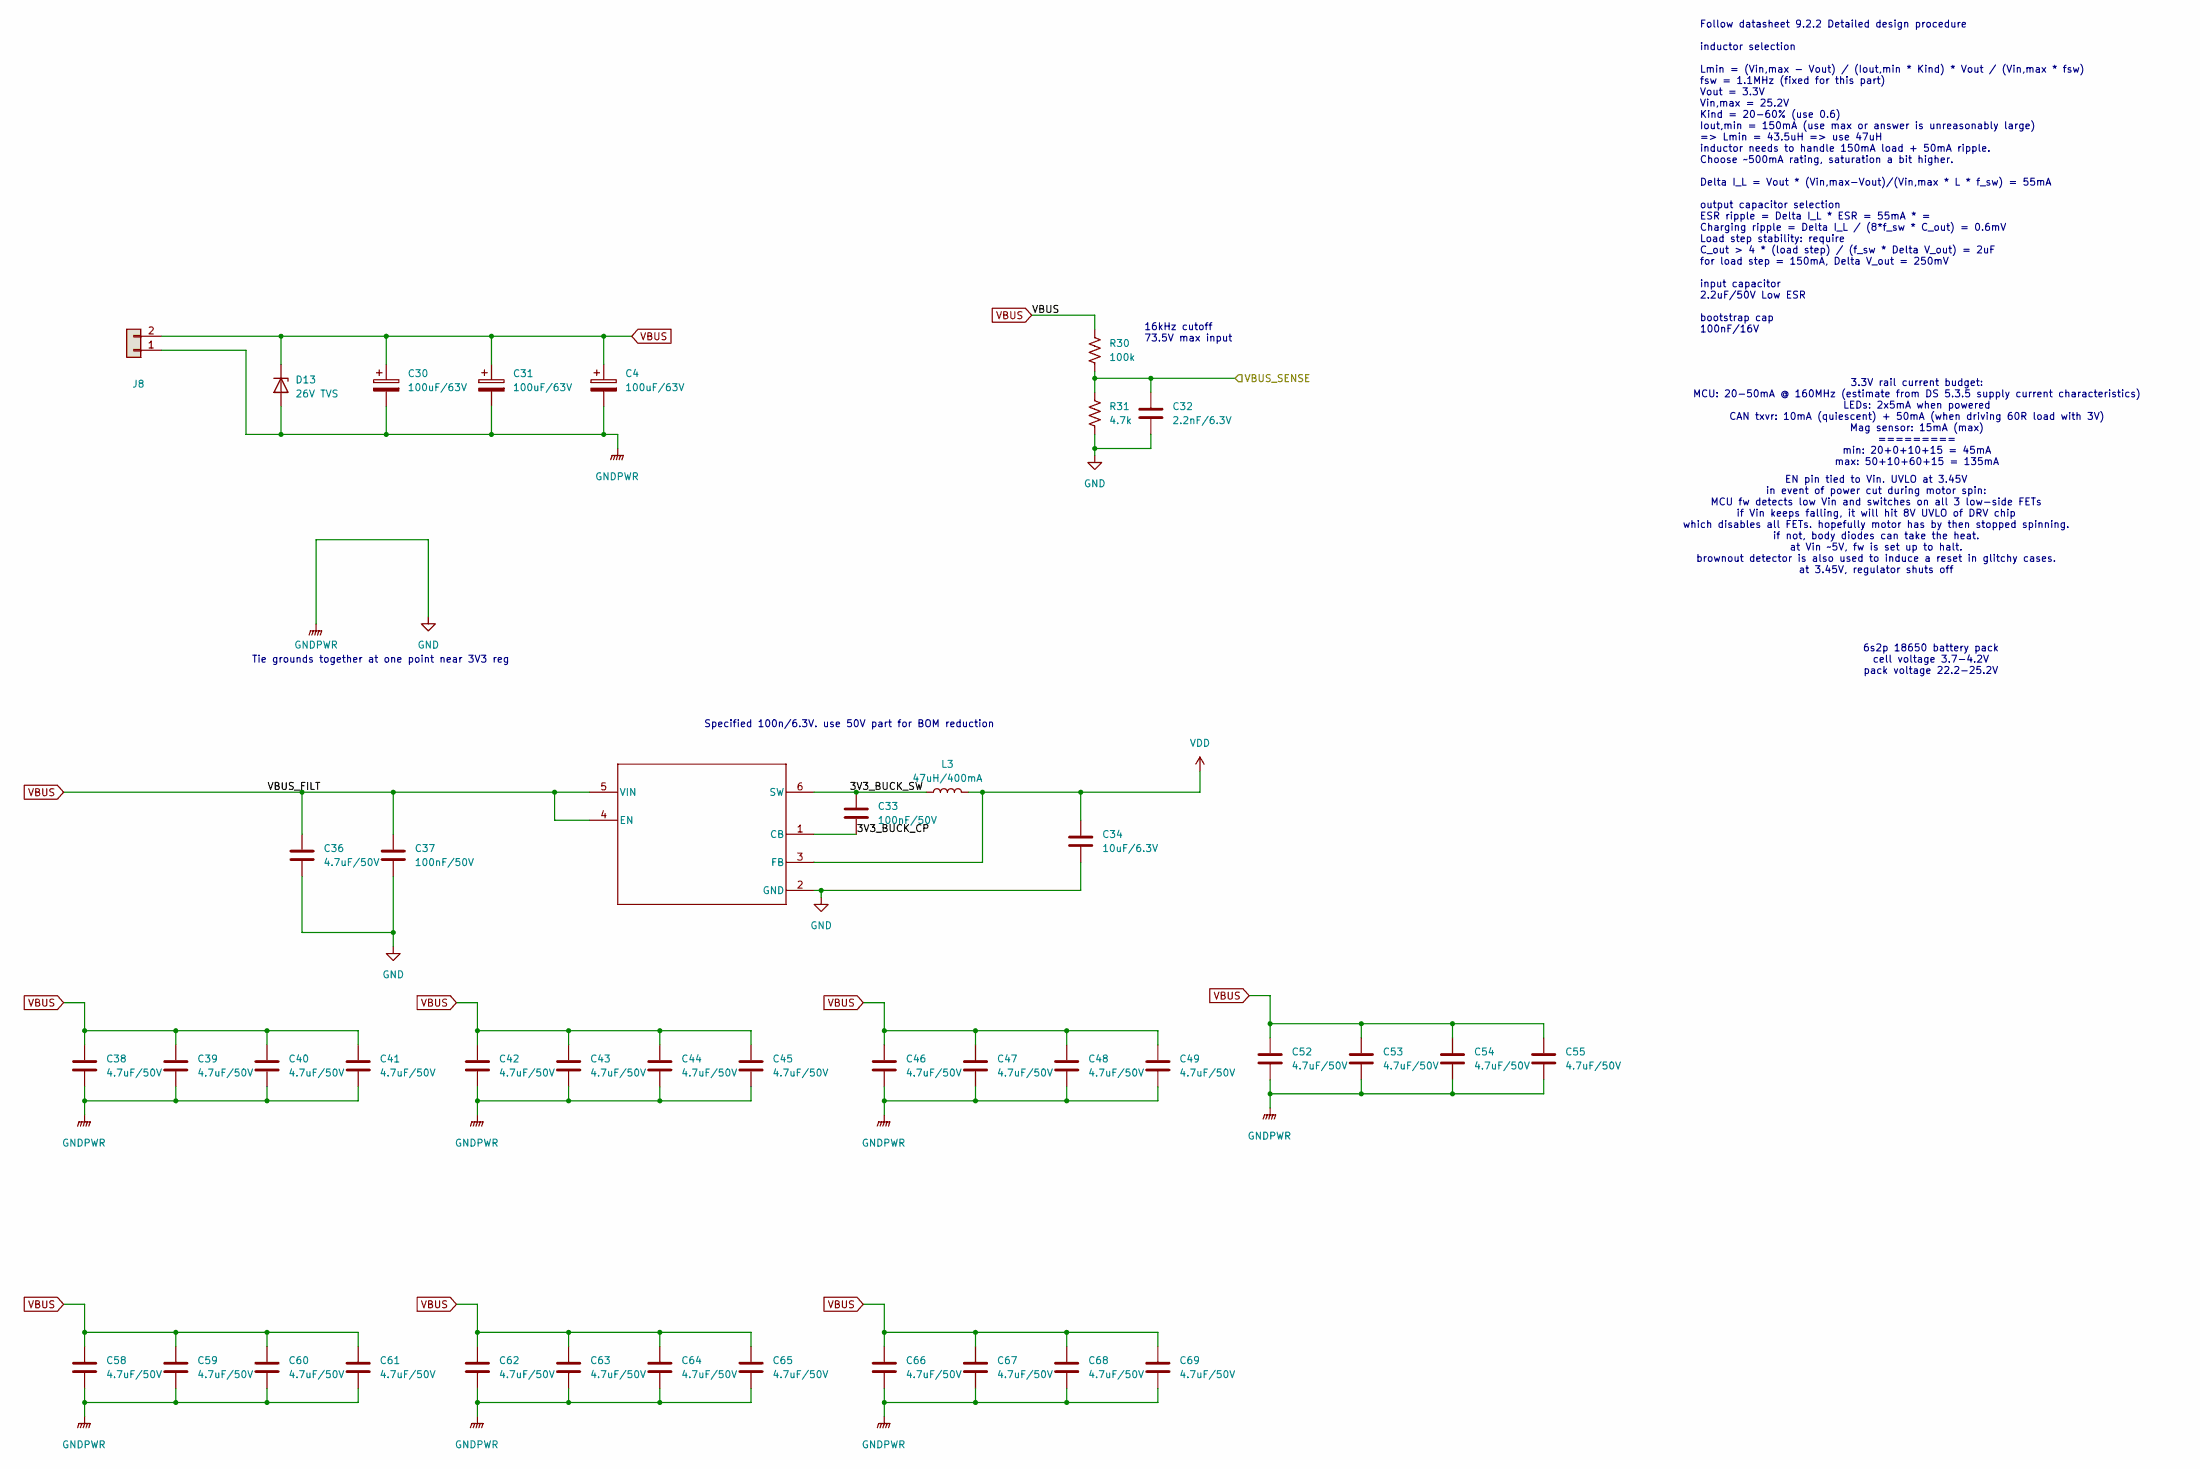
[picture p29: schematic Power_Supply.kicad_sch]

Parts:
C4, C30, C31: 100uF/63V; hn_C_Kemet_A768MS; part Kemet A768MS107M1JLAE027
C32: 2.2nF/6.3V; hn_C_0402; part Murata GRM155R70J222KA01D
C33, C37: 100nF/50V; hn_C_0603; part Murata GCJ188R71H104KA12D
C34: 10uF/6.3V; hn_C_0805; part Murata GCM21BR70J106KE22L
C36, C38, C39, C40, C41, C42, C43, C44, C45, C46, C47, C48, C49, C52, C53, C54, C55, C58, C59, C60, C61, C62, C63, C64, C65, C66, C67, C68, C69: 4.7uF/50V; hn_C_1206; part Murata GRM31CR71H475KA12L
D13: 26V TVS; hn_D_SMB; part Littelfuse SMBJ26A
J8: hn_AMASS_XT30PW-M; part Amass XT30-PW-M
L3: 47uH/400mA; hn_L_Bourns_SRN4026; part Bourns SRN4026-470M
R30: 100k; hn_R_0402; part YAGEO RC0402FR-07100KL
R31: 4.7k; hn_R_0402; part YAGEO RC0402JR-074K7L
U5: TPS560430X3FDBVR; hn_TPS560430X3F; part Texas Instruments TPS560430X3FDBVR

Connections:
/Microcontroller/ADC1_IN3: C32.1, R30.2, R31.1; also elsewhere on the board
/Power_Supply/3V3_BUCK_CP: C33.2, U5.1 (CB)
/Power_Supply/3V3_BUCK_SW: C33.1, L3.1, U5.6 (SW)
GND: C4.2, C30.2, C31.2, C32.2, C34.2, C36.2, C37.2, C38.2, C39.2, C40.2, C41.2, C42.2, C43.2, C44.2, C45.2, C46.2, C47.2, C48.2, C49.2, C52.2, C53.2, C54.2, C55.2, C58.2, C59.2, C60.2, C61.2, C62.2, C63.2, C64.2, C65.2, C66.2, C67.2, C68.2, C69.2, D13.2 (A), J8.1, R31.2, U5.2 (GND); also elsewhere on the board
VBUS: C4.1, C30.1, C31.1, C36.1, C37.1, C38.1, C39.1, C40.1, C41.1, C42.1, C43.1, C44.1, C45.1, C46.1, C47.1, C48.1, C49.1, C52.1, C53.1, C54.1, C55.1, C58.1, C59.1, C60.1, C61.1, C62.1, C63.1, C64.1, C65.1, C66.1, C67.1, C68.1, C69.1, D13.1 (K), J8.2, R30.1, U5.4 (EN), U5.5 (VIN); also elsewhere on the board
VDD: C34.1, L3.2, U5.3 (FB); also elsewhere on the board

Notes on the sheet:
Tie grounds together at one point near 3V3 reg
16kHz cutoff 73.5V max input
3.3V rail current budget: MCU: 20-50mA @ 160MHz (estimate from DS 5.3.5 supply current characteristics) LEDs: 2x5mA when powered CAN txvr: 10mA (quiescent) + 50mA (when driving 60R load with 3V) Mag sensor: 15mA (max) ========= min: 20+0+10+15 = 45mA max: 50+10+60+15 = 135mA
Follow datasheet 9.2.2 Detailed design procedure inductor selection Lmin = (Vin,max - Vout) / (Iout,min * Kind) * Vout / (Vin,max * fsw) fsw = 1.1MHz (fixed for this part) Vout = 3.3V Vin,max = 25.2V Kind = 20-60% (use 0.6) Iout,min = 150mA (use max or answer is unreasonably large) => Lmin = 43.5uH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
EN pin tied to Vin. UVLO at 3.45V in event of power cut during motor spin: MCU fw detects low Vin and switches on all 3 low-side FETs if Vin keeps falling, it will hit 8V UVLO of DRV chip which disables all FETs. hopefully motor has by then stopped spinning. if not, body diodes can take the heat. a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
6s2p 18650 battery pack cell voltage 3.7-4.2V pack voltage 22.2-25.2V
Specified 100n/6.3V. use 50V part for BOM reduction
