henrynester/spinor-r2/hw/r2.1/spinor-r2a.kicad_pcb

## KiCad design hw/r2.1/spinor-r2a.kicad_pcb (continued)

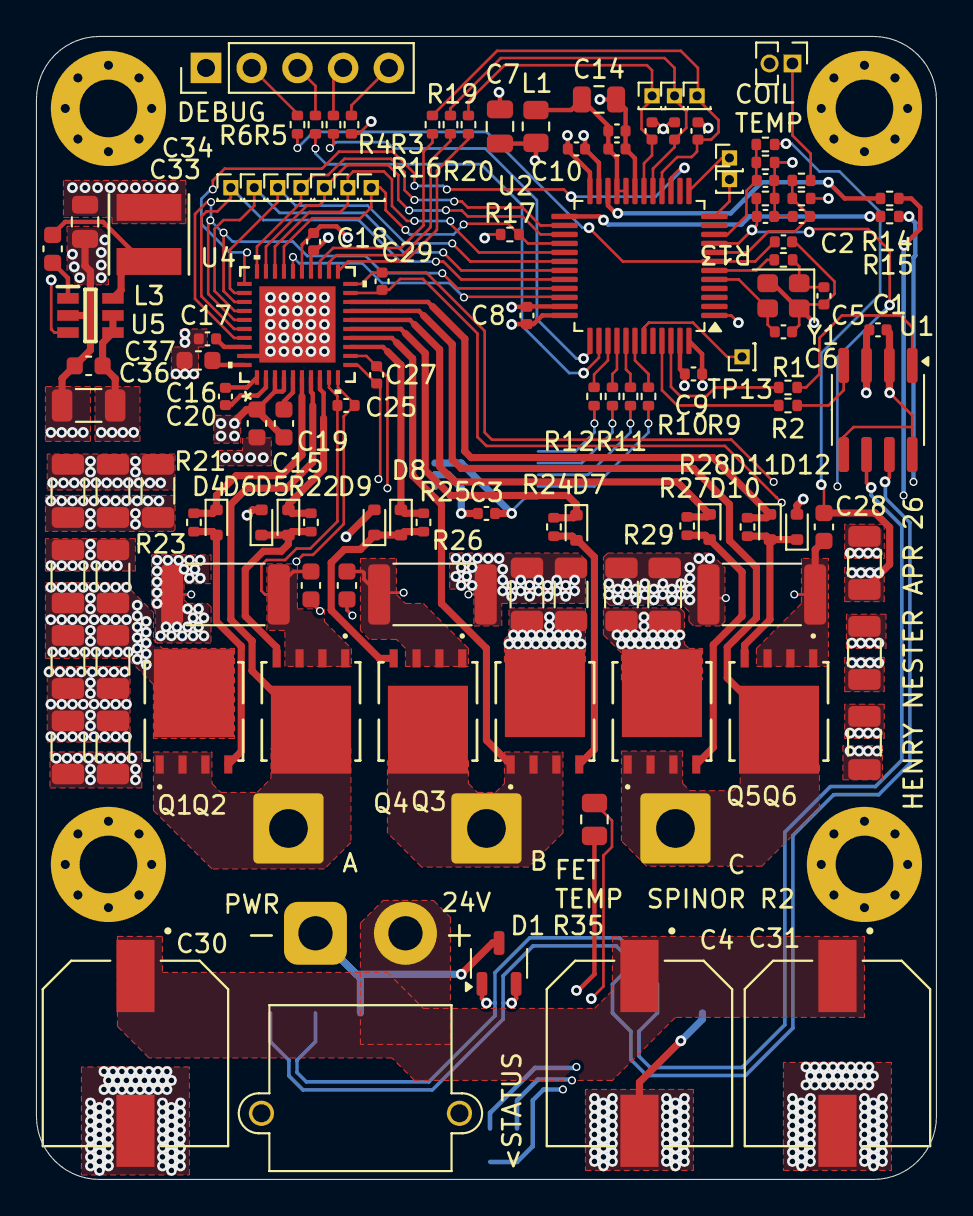
[picture p30: board spinor-r2a.kicad_pcb from above]

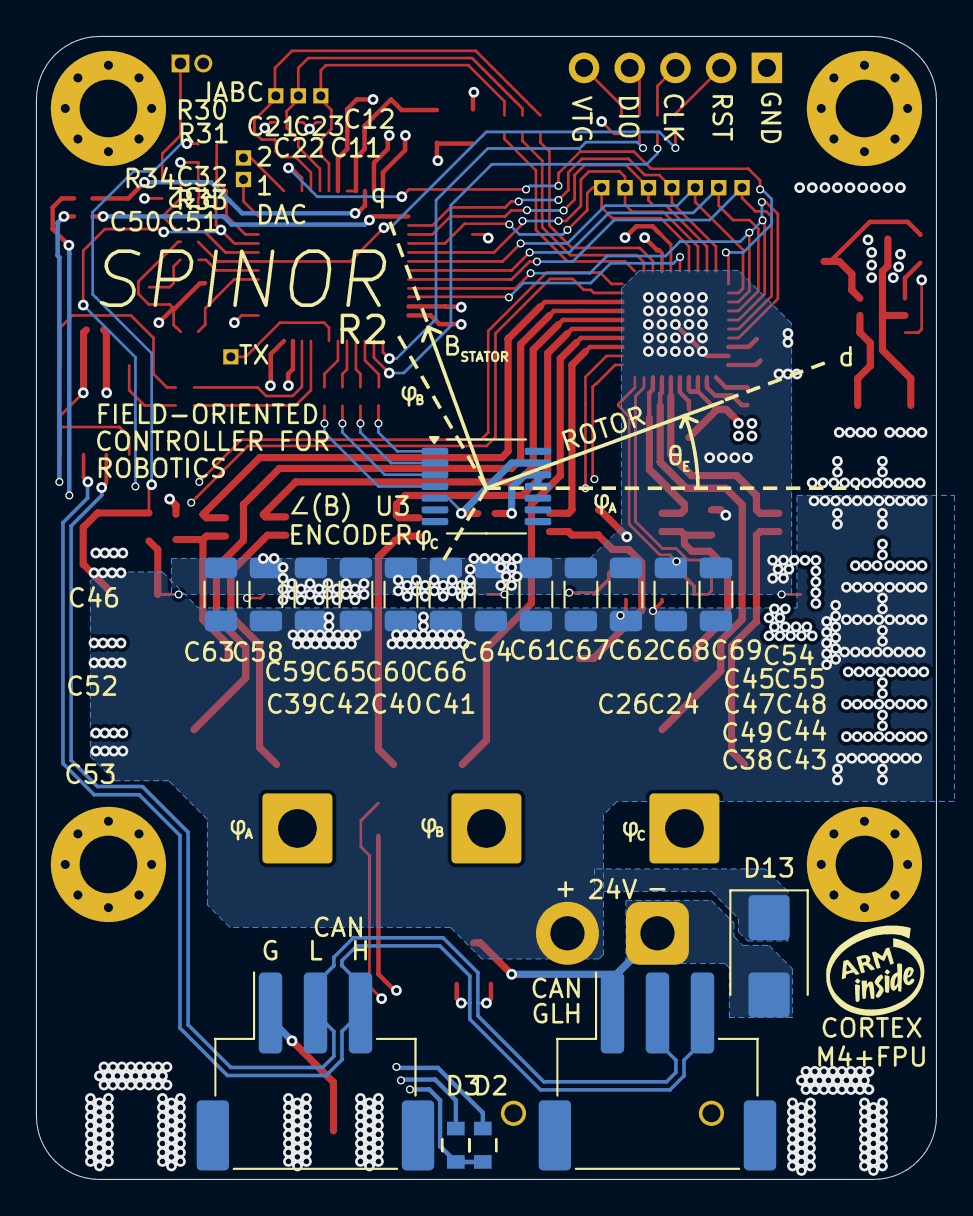
[picture p31: board spinor-r2a.kicad_pcb from below]

Board: 4 copper layers, 50.0 x 63.5 mm, 149 parts (18 on the bottom side), 80 nets.
