henrynester/spinor-r2/(commit log)

2026-01-27 first upload
    [FET_Half_Bridge.kicad_sch, Integrated_FET_Driver.kicad_sch, Microcontroller.kicad_sch, Power_Supply.kicad_sch, Thermistors.kicad_sch, hn_2512_shunt.step, hn_C_0402.step, hn_C_0603.step]
2026-01-30 start layout
    [FET_Half_Bridge.kicad_sch, Microcontroller.kicad_sch, Power_Supply.kicad_sch, spinor-r2a.kicad_pcb]
2026-01-31 placed more components
    [FET_Half_Bridge.kicad_sch, Integrated_FET_Driver.kicad_sch, Microcontroller.kicad_sch, Power_Supply.kicad_sch, Thermistors.kicad_sch, spinor-r2a.kicad_pcb]
2026-01-31 layout driver and 3v3 buck
    [Integrated_FET_Driver.kicad_sch, Power_Supply.kicad_sch, spinor-r2a.kicad_pcb]
2026-04-29 done routing!
    [Integrated_FET_Driver.kicad_sch, Microcontroller.kicad_sch, Power_Supply.kicad_sch, Thermistors.kicad_sch, spinor-r2a.kicad_pcb]
2026-04-29 sent to R2.0 to jlcpcb
    [spinor-r2a-B_Cu.gbl, spinor-r2a-B_Mask.gbs, spinor-r2a-B_Paste.gbp, spinor-r2a-B_Silkscreen.gbo, spinor-r2a-Edge_Cuts.gm1, spinor-r2a-F_Cu.gtl, spinor-r2a-F_Mask.gts, spinor-r2a-F_Paste.gtp]
2026-05-01 make hw and fw folders
    [FET_Half_Bridge.kicad_sch, Integrated_FET_Driver.kicad_sch, Microcontroller.kicad_sch, Power_Supply.kicad_sch, Thermistors.kicad_sch, hn_2512_shunt.step, hn_C_0402.step, hn_C_0603.step]
2026-06-20 archive c++ firmware
    [spinor-r2a.kicad_pcb]
2026-06-20 create next board rev
    [FET_Half_Bridge.kicad_sch, Integrated_FET_Driver.kicad_sch, Microcontroller.kicad_sch, Power_Supply.kicad_sch, Thermistors.kicad_sch, hn_2512_shunt.step, hn_C_0402.step, hn_C_0603.step]
