henrynester/spinor-r2/(notices)

Notices in the files:
hw/r2.1/hn_lib/3dmodels/hn_C_1206.step:
Copyright (C) 2017, kicad StepUp
This work is licensed under the [Creative Commons CC-BY-SA 4.0 License](https://creativecommons.org/licenses/by-sa/4.0/legalcode),
with the following exception:
To the extent that the creation of electronic designs that use 'Licensed Material' can be considered to be 'Adapted Material',
You are free to use the library data in your own projects without the obligation to share your project files under this or any other license agreement.
hw/r2.1/hn_lib/3dmodels/hn_R_0402.step:
Copyright (C) 2018, kicad StepUp
hw/r2.1/hn_lib/3dmodels/hn_D_SMB.step:
This program is free software: you can redistribute it and/or modify
it under the terms of the GNU General Public License as published by
the Free Software Foundation, either version 3 of the License, or
any later version.
itself might be covered by the GNU General Public License.
hw/r2.1/hn_lib/3dmodels/hn_xtal.step:
Copyright (C) 2024, KiCAD
This work is licensed under the
[Creative Commons CC-BY-SA 4.0 License](https://creativecommons.org/licenses/by-sa/4.0/legalcode),
project files under this or any other license agreement. However, if you wish to distribute
hw/r2.1/hn_lib/3dmodels/hn_LQFP48.step:
Copyright (C) 2025, KiCAD
